UnbDroid/WORK-2026/README.md

# WORK-2026
Repositório de códigos desenvolvidos pela equipe visando participação na categoria @Work da Competição Brasileira de Robótica.
