UnbDroid/WORK-2026/work_ws/src/salamander_bot/meshes/rplidar_a1m8_1.stl

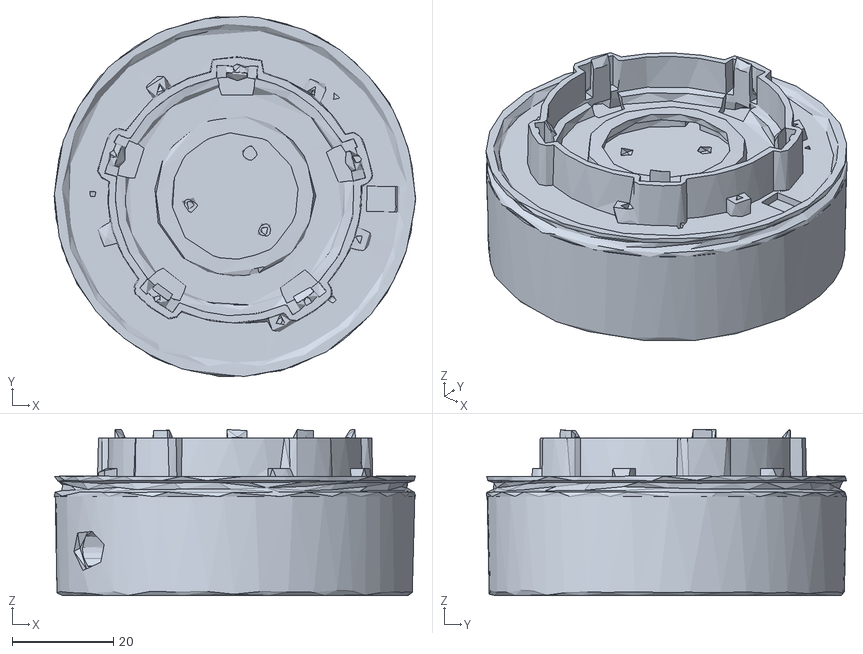
[picture p1: CAD file, 2026-08-21]
work_ws/src/salamander_bot/meshes/rplidar_a1m8_1.stl
71.3 x 70.9 x 32.7
