UnbDroid/WORK-2026/work_ws/src/salamander_bot/meshes/wheel_rf_1.stl

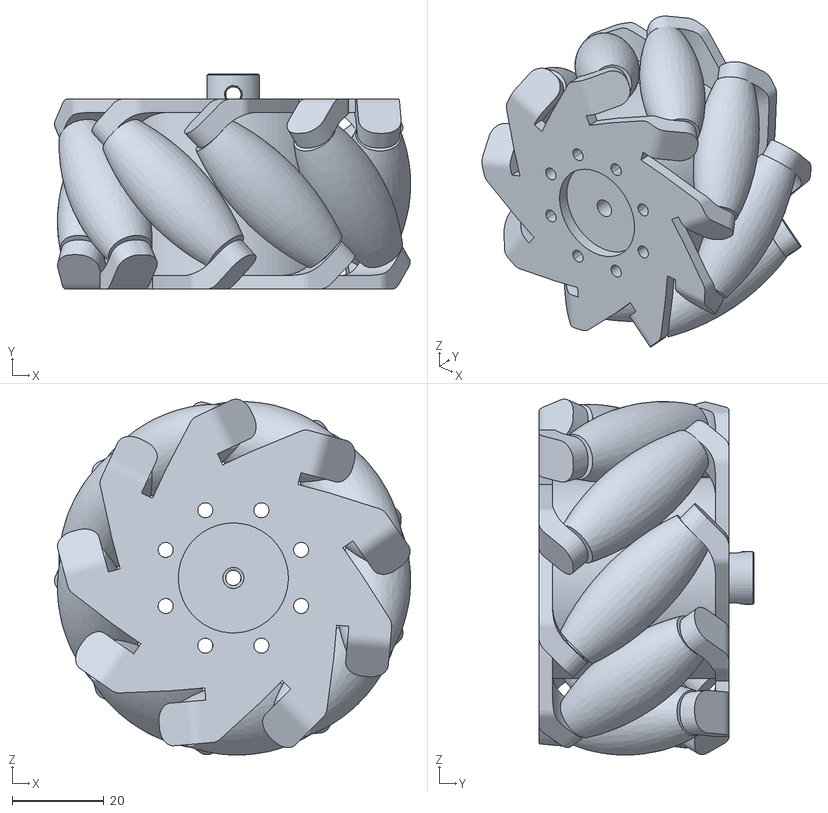
[picture p2: CAD file, 2026-08-21]
work_ws/src/salamander_bot/meshes/wheel_rf_1.stl
77.7 x 47.0 x 77.7
