UnbDroid/WORK-2026/work_ws/src/salamander_bot/meshes/webcam.stl

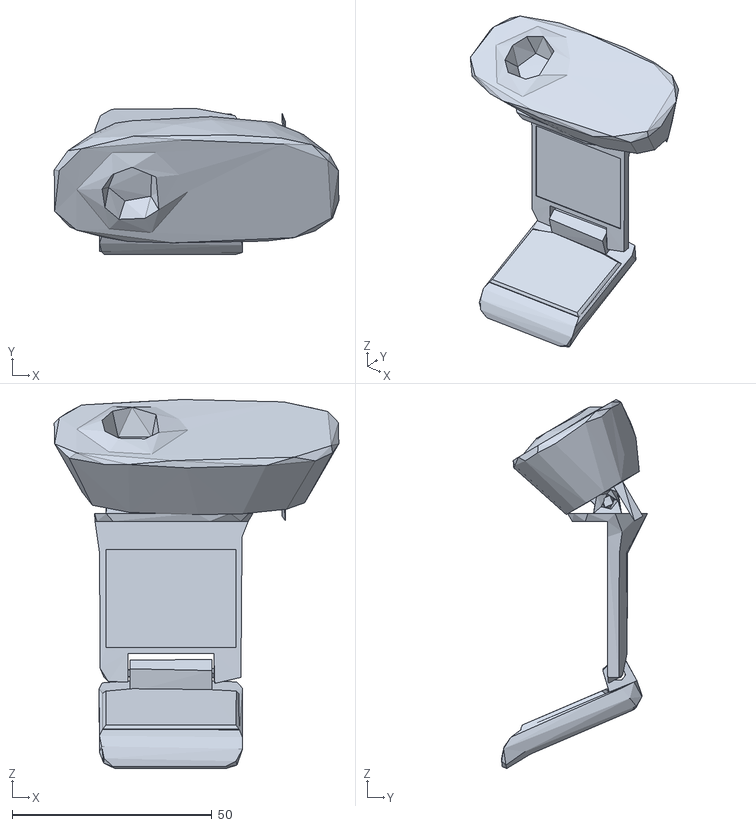
[picture p3: CAD file, 2026-08-21]
work_ws/src/salamander_bot/meshes/webcam.stl
71.2 x 36.5 x 92.3
