UnbDroid/WORK-2026/work_ws/src/salamander_bot/meshes/arm_link.stl

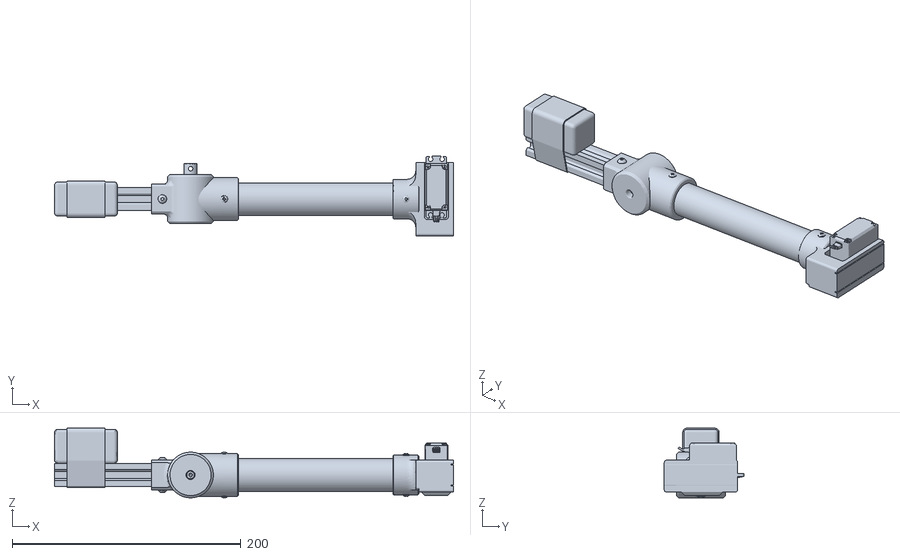
[picture p4: CAD file, 2026-08-21]
work_ws/src/salamander_bot/meshes/arm_link.stl
349.0 x 69.5 x 61.0
