UnbDroid/WORK-2026/work_ws/src/salamander_bot/meshes/base_link.stl

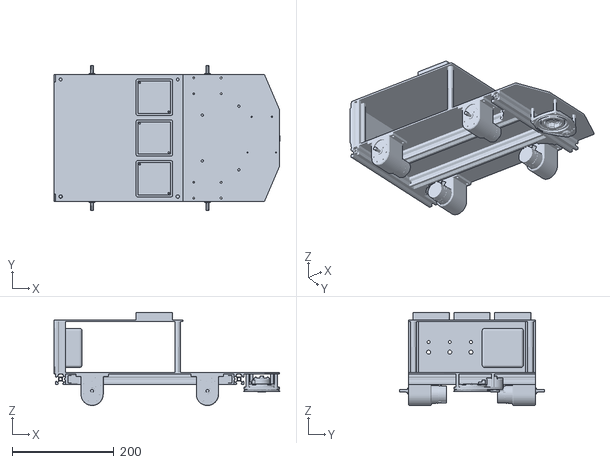
[picture p5: CAD file, 2026-08-21]
work_ws/src/salamander_bot/meshes/base_link.stl
443.7 x 284.0 x 182.7
