UnbDroid/WORK-2026/work_ws/src/salamander_bot/meshes/height_link.stl

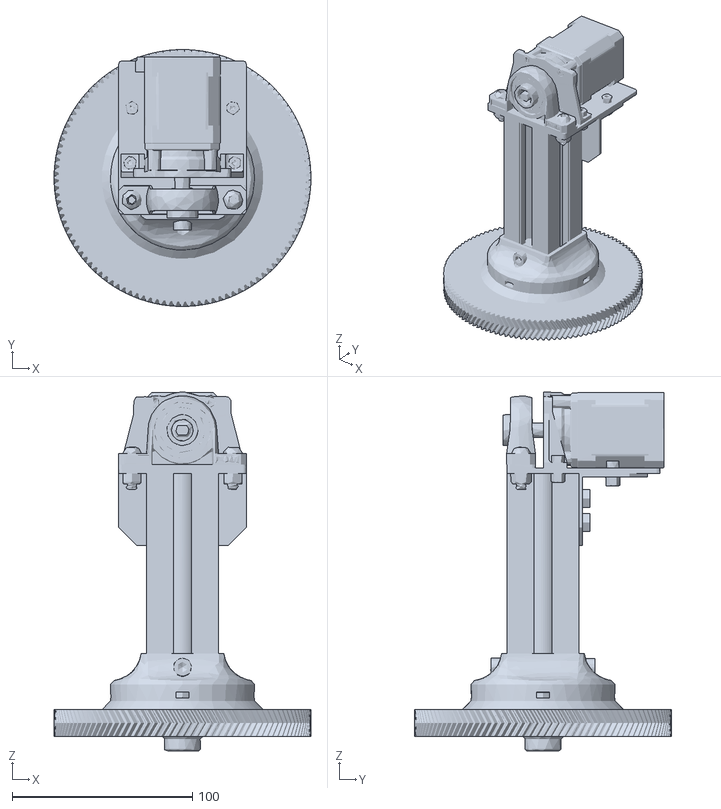
[picture p6: CAD file, 2026-08-04]
work_ws/src/salamander_bot/meshes/height_link.stl
142.5 x 142.5 x 199.2
