UnbDroid/WORK-2026/work_ws/src/salamander_bot/meshes/gripper_right.stl

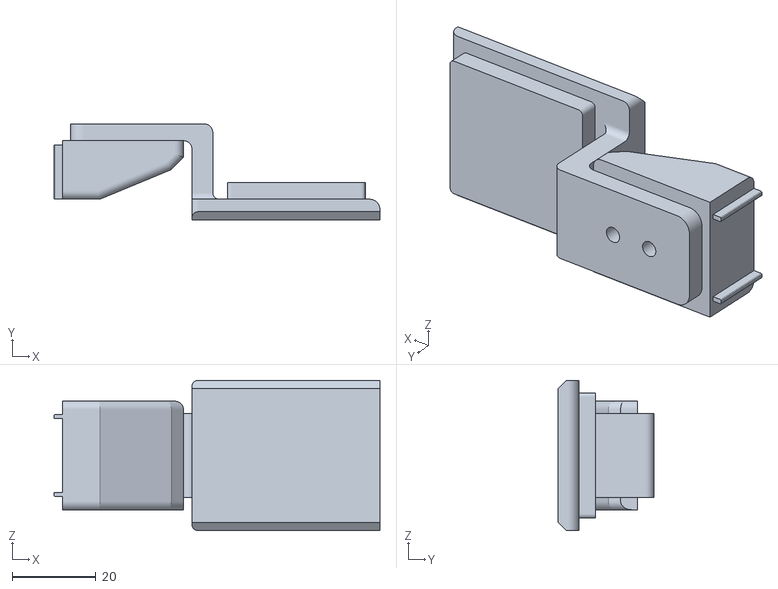
[picture p7: CAD file, 2026-08-04]
work_ws/src/salamander_bot/meshes/gripper_right.stl
78.0 x 23.0 x 36.0
