UnbDroid/WORK-2026/(list of files, cad)

Other CAD files:
work_ws/install/salamander_bot/share/salamander_bot/meshes/base_link.stl
work_ws/src/salamander_bot/meshes/wheel_rb_1.stl
work_ws/src/salamander_bot/meshes/wheel_lb_1.stl
work_ws/src/salamander_bot/meshes/wheel_lf_1.stl
work_ws/src/salamander_bot/meshes/gripper_left.stl
