UnbDroid/WORK-2026/firmware_navigation/include/Config.h

#ifndef CONFIG_H
#define CONFIG_H

// Microcontrolador: ESP32_DevKitC_V4.
// Pinos GPIO que Devem Ser Evitados em Geral: 6 a 11 (FLASH).
// Utilizar com Atenção: 0, 2, 5, 12 e 15 (BOOT, PULL-UP/DOWN e SPI) | 1 e 3 (TX/RX).
// Funcionam Somente com Leitura de Dados (INPUT): 34, 35, 36 e 39.

#define TICKS_PER_REVOLUTION        1440
#define PWM_FREQUENCY               15000
#define PWM_RESOLUTION              8
#define MAX_PWM                     255
#define WHEEL_RADIUS                0.04      // Wheel Radius in Meters.
#define DISTANCE_BETWEEN_WHEELS_X   0.11315   // Distance Between Wheels and Center of Robot (X Axes) in Meters.
#define DISTANCE_BETWEEN_WHEELS_Y   0.14875   // Distance Between Wheels and Center of Robot (Y Axes) in Meters.


#define M1_ENA          GPIO_NUM_26           // ENA Pin Connected to Motor Driver.
#define M1_ENB          GPIO_NUM_27           // ENB Pin Connected to Motor Driver.
#define M1_PWM          GPIO_NUM_13           // Enable Pin for PWM Control.
#define M1_ENC_A        GPIO_NUM_16           // Encoder A (Yellow Wire).
#define M1_ENC_B        GPIO_NUM_17           // Encoder B Pin (White Wire).
#define M1_CANAL_PWM    LEDC_CHANNEL_0
#define M1_KP           0.7
#define M1_KI           1.0

#define M3_ENA          GPIO_NUM_33
#define M3_ENB          GPIO_NUM_32
#define M3_PWM          GPIO_NUM_25
#define M3_ENC_A        GPIO_NUM_34
#define M3_ENC_B        GPIO_NUM_35         
#define M3_CANAL_PWM    LEDC_CHANNEL_1
#define M3_KP           0.7
#define M3_KI           1.0

#define M2_ENA          GPIO_NUM_22
#define M2_ENB          GPIO_NUM_23
#define M2_PWM          GPIO_NUM_4
#define M2_ENC_A        GPIO_NUM_15
#define M2_ENC_B        GPIO_NUM_14 
#define M2_CANAL_PWM    LEDC_CHANNEL_2
#define M2_KP           0.8
#define M2_KI           1.0

#define M4_ENA          GPIO_NUM_19
#define M4_ENB          GPIO_NUM_18
#define M4_PWM          GPIO_NUM_21
#define M4_ENC_A        GPIO_NUM_36           // VN
#define M4_ENC_B        GPIO_NUM_39           // VP
#define M4_CANAL_PWM    LEDC_CHANNEL_3
#define M4_KP           0.7
#define M4_KI           1.0

#endif // CONFIG_H
