UnbDroid/WORK-2026/firmware_manipulator/include/Config.h

#include <Arduino.h>

constexpr double GRIPPER_OPEN_ANGLE = PI;
constexpr double GRIPPER_CLOSE_ANGLE  = (7 * PI) / 12;

#define STEPS_PER_REV_ARM 872           // 200 Steps per Rotation (Full Step Mode) * 4.36:1 Gearbox.
#define STEPS_PER_REV_BASE 1400         // 200 Steps per Rotation (Full Step Mode) * 7:1 Gearbox.
#define MICROSTEPPING_MULT 16           // All Microstepping Pins Set to High.

#define ARM_HEIGHT 0.2075               // In Relation to Midplane of Base Driven Gear [Meters].
#define ARM_LATERAL_OFFSET 0.043666     // In Relation to Base Rotation Axis [Meters].
#define ARM_LENGTH 0.335                // In Relation to Arm Rotation Axis - Total Length: Arm + Gripper [Meters].

#define DIR_M1_PIN 26
#define STEP_M1_PIN 25
#define ENABLE_M1_PIN 27

#define MS1_M1_PIN 18
#define MS2_M1_PIN 19
#define MS3_M1_PIN 21

#define DIR_M2_PIN 22
#define STEP_M2_PIN 23
#define ENABLE_M2_PIN 33

#define MS1_M2_PIN 4
#define MS2_M2_PIN 16
#define MS3_M2_PIN 17

#define GRIPPER_PIN 13
