UnbDroid/WORK-2026/firmware_navigation/include/MotorDC.h

#ifndef MOTORDC_H
#define MOTORDC_H

class MotorDC {
    private:
        uint8_t in1;
        uint8_t in2;
        uint8_t pwm;
        uint8_t enc_a;
        uint8_t enc_b;
        uint8_t canal_pwm;
        volatile long ticks_contador;
        long ticks_anterior;
        unsigned long tempo_anterior_rpm;
        unsigned long tempo_anterior_pi;
        bool direction; // (false = Straight) | (true = Backwards). 
        float pwm_atual;
        float rpm_alvo;
        float rpm_anterior;
        volatile double rpm_atual;
        volatile double erro_acumulado;
        double erro_atual;
        const float Kp;
        const float Ki;
    public:
        MotorDC(uint8_t in1, uint8_t in2, uint8_t pwm, uint8_t canal_pwm, uint8_t enc_a, uint8_t enc_b, float Kp, float Ki);
        void init();
        void lerEncoder();
        void mover_rpm(float rpm);
        void mover_pwm(uint32_t pwm, bool direction);
        float calcularRPM();
        double updatePI(float rpm_alvo);
        double feedforward(float rpm);

        long getTicks() { return this->ticks_contador; }
        long getTicksAnterior() { return this->ticks_anterior; }
        float getRPMAtual() { return this->rpm_atual; }
        float getErroAtual() { return this->erro_atual; }
        float getPWMAtual() { return this->pwm_atual; }
        bool getDirection() { return this->direction; }
};

#endif // MOTORDC_H
