UnbDroid/WORK-2026/firmware_navigation/test/move_test.cpp

#include <Arduino.h>
#include "Config.h"
#include "MotorDC.h"
#include "driver/ledc.h"
#include "Robot.h"

MotorDC motor1(M1_ENA, M1_ENB, M1_PWM, M1_CANAL_PWM, M1_ENC_A, M1_ENC_B, M1_KP, M1_KI);
MotorDC motor2(M2_ENA, M2_ENB, M2_PWM, M2_CANAL_PWM, M2_ENC_A, M2_ENC_B, M2_KP, M2_KI);
MotorDC motor3(M3_ENA, M3_ENB, M3_PWM, M3_CANAL_PWM, M3_ENC_A, M3_ENC_B, M3_KP, M3_KI);
MotorDC motor4(M4_ENA, M4_ENB, M4_PWM, M4_CANAL_PWM, M4_ENC_A, M4_ENC_B, M4_KP, M4_KI);

void IRAM_ATTR isr_m1() { motor1.lerEncoder(); }
void IRAM_ATTR isr_m2() { motor2.lerEncoder(); }
void IRAM_ATTR isr_m3() { motor3.lerEncoder(); }
void IRAM_ATTR isr_m4() { motor4.lerEncoder(); }

Robot RobotWS(motor1, motor2, motor3, motor4);

unsigned long tempo_anterior_print = 0;
unsigned long tempo_decorrido = 0;
unsigned long tempo_inicio = 0;

void setup() {
  Serial.begin(115200);

  motor1.init();
  motor2.init();
  motor3.init();
  motor4.init();

  attachInterrupt(digitalPinToInterrupt(M1_ENC_A), isr_m1, RISING);
  attachInterrupt(digitalPinToInterrupt(M2_ENC_A), isr_m2, RISING);
  attachInterrupt(digitalPinToInterrupt(M3_ENC_A), isr_m3, RISING);
  attachInterrupt(digitalPinToInterrupt(M4_ENC_A), isr_m4, RISING);
  
  tempo_inicio = millis();
}

void loop() {
  unsigned long tempo_atual = millis();
  tempo_decorrido = tempo_atual - tempo_inicio;

if (tempo_decorrido < 5000) { 
    RobotWS.moveRobot(0.2, 0.0, 0.0);
  } else if (tempo_decorrido < 10000) { 
    RobotWS.moveRobot(-0.2, 0.0, 0.0);
  } else if (tempo_decorrido < 20000) {
    RobotWS.moveRobot(0.0, 0.0, 1.0);
  } else if (tempo_decorrido < 30000) {
    RobotWS.moveRobot(0.0, 0.0, -1.0);
  } else if (tempo_decorrido < 35000) {
    RobotWS.moveRobot(0.0, 0.2, 0.0);
  } else if (tempo_decorrido < 40000) {
    RobotWS.moveRobot(0.0,-0.2, 0.0);
  } else {
    RobotWS.moveRobot(0.0, 0.0, 0.0);
  }
  
  if(tempo_atual - tempo_anterior_print >= 500) {
    Serial.printf("Motor 1 | RPM: %.2f | Erro: %.2f | PWM: %.2f\n", motor1.getRPMAtual(), motor1.getErroAtual(), motor1.getPWMAtual());
    Serial.printf("Motor 2 | RPM: %.2f | Erro: %.2f | PWM: %.2f\n", motor2.getRPMAtual(), motor2.getErroAtual(), motor2.getPWMAtual());
    Serial.printf("Motor 3 | RPM: %.2f | Erro: %.2f | PWM: %.2f\n", motor3.getRPMAtual(), motor3.getErroAtual(), motor3.getPWMAtual());
    Serial.printf("Motor 4 | RPM: %.2f | Erro: %.2f | PWM: %.2f\n", motor4.getRPMAtual(), motor4.getErroAtual(), motor4.getPWMAtual());
    tempo_anterior_print = tempo_atual;
  }
}
