UnbDroid/WORK-2026/firmware_navigation/test/micro_ros_test.cpp

#include <Arduino.h>
#include <micro_ros_platformio.h>

#include <rcl/rcl.h>
#include <rclc/rclc.h>
#include <rclc/executor.h>

#include <std_msgs/msg/int32.h>

#define LED_PIN 2           
#define RCCHECK(fn) { rcl_ret_t temp_rc = fn; if((temp_rc != RCL_RET_OK)){error_loop();}}
#define RCSOFTCHECK(fn) { rcl_ret_t temp_rc = fn; if((temp_rc != RCL_RET_OK)){}}

rcl_publisher_t publisher;
std_msgs__msg__Int32 msg;
rclc_executor_t executor;
rclc_support_t support;
rcl_allocator_t allocator;
rcl_node_t node;
rcl_timer_t timer;

void error_loop(){
  while(1){
    digitalWrite(LED_PIN, !digitalRead(LED_PIN));
    delay(100);
  }
}

void timer_callback(rcl_timer_t * timer, int64_t last_call_time)
{
  RCLC_UNUSED(last_call_time);
  if (timer != NULL) {
    RCSOFTCHECK(rcl_publish(&publisher, &msg, NULL));
    msg.data++;
  }
}

void setup() {
  Serial.begin(115200);
  set_microros_serial_transports(Serial);

  pinMode(LED_PIN, OUTPUT);
  digitalWrite(LED_PIN, HIGH);
  delay(2000);

  allocator = rcl_get_default_allocator();

  RCCHECK(rclc_support_init(&support, 0, NULL, &allocator));

  RCCHECK(rclc_node_init_default(&node, "esp32_node", "", &support));

  RCCHECK(rclc_publisher_init_default(
    &publisher,
    &node,
    ROSIDL_GET_MSG_TYPE_SUPPORT(std_msgs, msg, Int32),
    "micro_ros_counter"));

  const unsigned int timer_timeout = 1000;
  RCCHECK(rclc_timer_init_default(
    &timer,
    &support,
    RCL_MS_TO_NS(timer_timeout),
    timer_callback));

  RCCHECK(rclc_executor_init(&executor, &support.context, 1, &allocator));
  RCCHECK(rclc_executor_add_timer(&executor, &timer));

  msg.data = 0;
}

void loop() {
  delay(100);
  RCCHECK(rclc_executor_spin_some(&executor, RCL_MS_TO_NS(100)));
}
