UnbDroid/WORK-2026/(commit log)

2026-01-26 Adiciona novos diretórios e arquivos de inicialização.
2026-01-26 Adiciona diretórios para ROS2.
2026-01-26 Teste de comunicação ROS2 e MicroRos.
2026-01-27 ESP-IDF Project for DC Motor PWM Control (Working)
2026-01-28 Adiciona arquivo de configuração
2026-01-28 Adiciona código de leitura de encoders.
2026-01-30 Refatoração de código de leitura de encoders.
2026-02-02 Adicionado Pasta de Componentes e Header de Configuração dos Pinos
2026-02-04 Implementa código para controle PID dos motores
2026-02-05 Correção de Dupla Configuração de Pinos PWM (LEDC e GPIO_OUTPUT) e Sintaxe de Bit Mask
2026-02-08 Adicionado Leitura de Encoder e Cálculo de RPM
2026-02-11 Implementação de teste de zona morta de PWM dos motores.
2026-02-26 Mudança no Controle PI, Verificação de Direção e Mudança de Pinos
2026-02-26 Adicionado Implementação de Cinemática Inversa das Rodas Mecanum (Ajustar Constantes PI)
2026-02-27 Implementação de Cinemática Inversa, Feedforward no Controle PI e Ajustes nos Tipos das Variáveis do Construtor
2026-03-28 Implementação de Nó Subscriber Para Leitura de Tópico /cmd_vel, Integração de Motores e Envio de Velocidade Linear e Angular Manualmente via CLI da Raspberry PI
2026-03-28 Removendo Projeto de Estudo do Framework ESP-IDF
2026-04-01 Medição de Velocidade em RPM para Odometria e Teleoperação Testada
2026-04-07 Leitura de RPM em rad/s
2026-04-20 Restruturação de Repositório ROS 2 Para Versionamento (Separação de Workspaces Dev e Robô)
    [robot.urdf.xacro]
2026-04-20 Adição de Diretórios e Ajustes
2026-05-01 Testes no Rviz e Adição de Pacote URDF Convertido do Modelo do Fusion 360
    [colors.xacro, materials.xacro, robot.urdf.xacro, robot_core.xacro, rplidar_a1m8_1.stl, salamander_bot.xacro, wheel_lb_1.stl, wheel_lf_1.stl]
2026-05-01 Ajustes e Organização do Pacote de Simulação do Robô - Integração URDF, Rviz e Gazebo
    [colors.xacro, materials.xacro, robot.urdf.xacro, robot_core.xacro, rplidar_a1m8_1.stl, salamander_bot.xacro, wheel_lb_1.stl, wheel_lf_1.stl]
2026-05-01 Adicionando Documentação de Workspace Dev
2026-05-05 Adicionando a odometria
    [base_link.stl, colors.xacro, robot.urdf.xacro, robot_core.xacro, rplidar_a1m8_1.stl, wheel_lb_1.stl, wheel_lf_1.stl, wheel_rb_1.stl]
2026-05-11 Simplificando Organização do Repositório do ROS2
    [colors.xacro, robot.urdf.xacro, robot_core.xacro, rplidar_a1m8_1.stl, wheel_lb_1.stl, wheel_lf_1.stl, wheel_rb_1.stl, wheel_rf_1.stl]
2026-05-11 Organização de Diretórios
    [base_link.stl, colors.xacro, robot.urdf.xacro, robot_core.xacro, rplidar_a1m8_1.stl, wheel_lb_1.stl, wheel_lf_1.stl, wheel_rb_1.stl]
2026-05-16 SLAM e edicoes pra simular o lidar
    [lidar.xacro, robot_core.xacro]
2026-05-19 Configuração básica dos pacotes de visão.
2026-05-20 Código funcional com publicação de informações sobre os cubos detectados.
2026-05-21 Arquivo com URDF e transformadas estáticas prontas
    [robot_core.xacro]
2026-05-29 Adição de URDF Com Posição do LIDAR Atualizado
    [rplidar_a1m8_1.stl, salamander_bot.xacro, wheel_lb_1.stl, wheel_lf_1.stl, wheel_rb_1.stl, wheel_rf_1.stl]
2026-06-03 scripts de setup e odometria
2026-06-03 Atualização do script de setup
2026-06-05 Constates de MAX.RPM e DEADZONE modificadas.
    [base_link.stl, colors.xacro, lidar.xacro, robot.urdf.xacro, robot_core.xacro, rplidar_a1m8_1.stl, wheel_lb_1.stl, wheel_lf_1.stl]
2026-06-05 Exemplo de arquivos de domínio, problema e plano em PDDL
2026-06-09 Arrumando o erro da navegação
    [colors.xacro, lidar.xacro, robot.urdf.xacro, robot_core.xacro, rplidar_a1m8_1.stl, wheel_lb_1.stl, wheel_lf_1.stl, wheel_rb_1.stl]
2026-06-10 9/06 - correção de erros da navegação e lidar
2026-06-10 limpeza build install e log + edição xacros
    [colors.xacro, lidar.xacro, robot.urdf.xacro, robot_core.xacro, rplidar_a1m8_1.stl, salamander_bot.xacro, wheel_lb_1.stl, wheel_lf_1.stl]
2026-06-11 edição de odom->odom_rf2o
2026-06-12 Criação de Pacote e Configuração Inicial Para Simulação do Manipulador
    [model-1_2.sdf, model-1_3.sdf, model-1_4.sdf, model.sdf]
2026-06-12 Added Manipulator Stepper + Servo Motor Test Codes
2026-06-17 Added FastAccelStepper Library, Constants for Full Revolution Motors Considering Gearbox Output & Microstepping Tests
2026-06-17 simulação do lidar no gazebo
    [lidar.xacro, mundo.sdf, robot.urdf.xacro, robot_core.xacro, salamander_bot.xacro]
2026-06-17 filtro das rodas - teste 1
    [robot_body_filter.yaml]
2026-06-18 atualização-nome de arquivo
2026-06-18 Added Code to Control Arm Joint & Servo, Added Enable Pins
2026-06-19 edicoes-correcao launch
    [salamander_bot.xacro]
2026-06-19 solucao de erro do filtro
    [robot_body_filter.yaml]
2026-06-25 Added Manipulator Class (With Minor Tests for Joint Positioning)
2026-06-26 Added Simple Forward Kinematics to drive the Manipulator in radians, solve arm not responding if autoEnable(false) and tweaks in vel/acel values
2026-06-26 edição de nós - filtro
    [robot_body_filter.yaml]
2026-06-26 filtro funcionando
    [robot_body_filter.yaml]
2026-06-30 Nav2 funcionando, params lidar.xacro modificados
    [lidar.xacro]
2026-07-01 Added Inverse Kinematics Function Derived Mathematically From Robot Arm Physical Model, Reachability Verification and Minor Improvements
2026-07-03 Added struct and functions for ik & fk calculations, test for printing data on screen
2026-07-06 Removing simulation models
    [model-1_2.sdf, model-1_3.sdf, model-1_4.sdf, model.sdf]
2026-07-06 Removed sample text from firmware_manipulator README.md
2026-07-13 atualização - base_footprint
    [salamander_bot.xacro]
2026-07-13 Added Micro-ROS Code & Serial Comunication Esp32 <=> ROS2 DEV_WS Working
2026-07-27 Adição do planejamento de rodada do Basic Manipulation Test
2026-07-27 Adiciona arquivos de problema de Basic Manipulation Test e Basic Trasnsportation Test
2026-07-30 Changes: Increased PWM Frequency to 15 Khz, M2 Pin Changes And Tweaked PI Constants
2026-07-30 inflation radius, footprint alterados
2026-07-30 Arrumei o rviz (robo estava voando)
    [salamander_bot.xacro]
2026-08-03 Adicionado URDF Inicial de Robô Final (Manipulador + Chassi + Câmera + LIDAR) (Corrigir Câmera e LIDAR) & Correção na Modelagem da Cinemática Inversa da Movimentação - ESTAVA EM RAD/S AO INVÉS DE M/S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
    [arm_link.stl, arm_platform.xacro, gripper_left.stl, gripper_right.stl, lidar.xacro, salamander_bot.xacro, webcam.stl, webcam.xacro]
2026-08-04 Reorganização de Arquivos URDF do Chassi, Posições de Frames Atualizados, Simplificação no Modelo de Colisão (Ainda tem Muita Coisa a Ajustar com Relação ao Visual), Alteração da Posição X,Y das Roda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
    [base_link_collision.stl, height_link.stl, lidar.xacro, rplidar_a1m8.stl, salamander_bot.xacro, wheel_lb.stl, wheel_lf.stl, wheel_rb.stl]
2026-08-04 Retirada de Arquivos .STL Antigos e Adaptação ao Visual Simplificado
    [base_link.stl, lidar.xacro, rplidar_a1m8.stl, salamander_bot.xacro, wheel_lb.stl, wheel_lf.stl, wheel_rb.stl, wheel_rf.stl]
2026-08-04 Adicionado Parâmetros de Inércia e Massa
    [lidar.xacro, salamander_bot.xacro]
2026-08-04 Mudança de Arquivo de Configuração
2026-08-04 Correção nos Arquivos de URDF Provenientes de Erro no Merge
    [lidar.xacro, salamander_bot.xacro]
2026-08-05 Adiciona equações dos motores
2026-08-05 Corrigindo URDF do robo
    [lidar.xacro, salamander_bot.xacro]
2026-08-05 Robo tava girado 90 graus
    [salamander_bot.xacro]
2026-08-05 Ajuste de erro URDF
    [lidar.xacro, salamander_bot.xacro]
2026-08-05 Teste de Orientação de Coordenadas
    [inertial_macros.xacro, lidar.xacro, salamander_bot.xacro]
2026-08-06 Voltando ao URDF antigo
    [lidar.xacro, salamander_bot.xacro]
2026-08-06 Voltando ao URDF antigo antigo de verdade
    [lidar.xacro, salamander_bot.xacro]
2026-08-06 Agora vai
    [salamander_bot.xacro]
2026-08-10 teste 1: atulização do URDF - correção de erro
    [base_link.stl, base_link_collision.stl, rplidar_a1m8_1.stl, wheel_lb_1.stl, wheel_lf_1.stl, wheel_rb_1.stl, wheel_rf_1.stl]
2026-08-13 parametros de colisão, alinhamento de direção e de navegação alterados
2026-08-13 URDF Câmera + Braço (Ajustar Inércia e Centro de Massa Para Simulação)
    [arm_platform.xacro, lidar.xacro, salamander_bot.xacro, webcam.xacro]
2026-08-13 Redução de Faces e Vértices dos Modelos
    [arm_link.stl, base_link.stl, rplidar_a1m8_1.stl, webcam.stl, wheel_lb_1.stl, wheel_lf_1.stl, wheel_rb_1.stl, wheel_rf_1.stl]
2026-08-15 Separa os tópicos de coordenadas e de dados dos cubos
2026-08-18 porta alterada do lidar
2026-08-18 detecção de cor
2026-08-19 detecção de cores
2026-08-22 transformada de coordenadas da visao para o braço
2026-08-25 correçao de erro - bringup file
2026-09-07 Correção da detecção de cores com coordenadas
2026-09-08 Adicionando o framework PlanSys2, o nó de movimentação para nav + PDDL
2026-09-11 Testando com um frame fixo na base do manipulador
    [arm_platform.xacro]
2026-09-14 Pinos dos motores organizados e main.cpp descomentado
2026-09-16 Correção na Definição dos Pinos e Enable do Motor do Braço Para Testes
2026-09-17 Pinos dos motores agora estao certos
2026-09-17 Teste de ajuste de velocidade do eixo z
2026-09-19 criando novo package de controle do braço
2026-09-19 correção de erros
2026-09-19 adição de coordenadas teste
2026-09-21 novas coordenadas dos slots
2026-09-21 mudando coordenadas dos slots
2026-09-22 Pinos dos motores atualizados novamente: estranho
2026-09-22 valores de alinhamento atualizados
2026-09-25 Correção nos Pinos (Testados Pelo Código Teste de Movimentação)
2026-10-01 atualização do código de prioridade
2026-10-01 Tópico Para Enviar Comandos da Garra e Correção no Frame do Manipulador (Funcionando)
2026-10-02 mudanças muitas no arquivo de domínio e um caso teste
2026-10-05 Mudanças de Formatação
2026-10-05 Posições dos Slots e Ajuste na Cinemática Para o Manipulador Ir para o Ponto Mais Próximo
2026-10-06 Retirando Publicação da Velocidade das Rodas no Micro-ROS
2026-10-06 arq de problema e dominio atualizados para pegar e colocar cubo no slot
2026-10-06 Comunicação visao -> braço deletada e correção de erros
2026-10-06 Nos de ações do braço feitos
2026-10-07 retornando o arquivo de dominio
2026-10-07 Nos de ação e no geral do braço
2026-10-08 Alteracoes no vision_node - diminuicao de tolerancia e ajustes de alinhamento
2026-10-13 Correcao de procura de tag
2026-10-14 mudança no vision_node para pegar tag especificada
2026-10-19 atualizacoes de velocidade e coordenadas
2026-10-19 adicionando logica de andar pra trás antes de se alinhar
2026-10-20 mudanças para deixar tudo pronto para o BMT e BTT1
2026-10-21 edicoes de alinhamento e correcao da coordenada
2026-10-21 mudanca de alinhamento com yaw
2026-10-22 git commit -m "voltando alinhamento e coordenadas"
2026-10-22 ajuste na taxa de atualização do PI e modificação na velocidade de ré do robô
2026-10-27 Mudança em Parâmetros de Movimentação
2026-10-27 arquivos pddl prontos para BTT1
2026-10-28 Atualiza coordenadas de queda do cubo e ajusta lógica de alinhamento no nó de visão
2026-10-30 Atualiza lógica de detecção e alinhamento de cubos
2026-11-02 Muitas mudanças, logica de alinhamento, coordenadas, mapa, entre outros
2026-11-07 ajustes para o BTT2
2026-11-09 atualizacao da logica do container com deteccao de cor
2026-11-12 Adicao de ajustes de alinhamento com container
2026-11-13 atualizando deteccao de tags
